Dafaruz/Arduino_prj/pic/solid asm full2.png

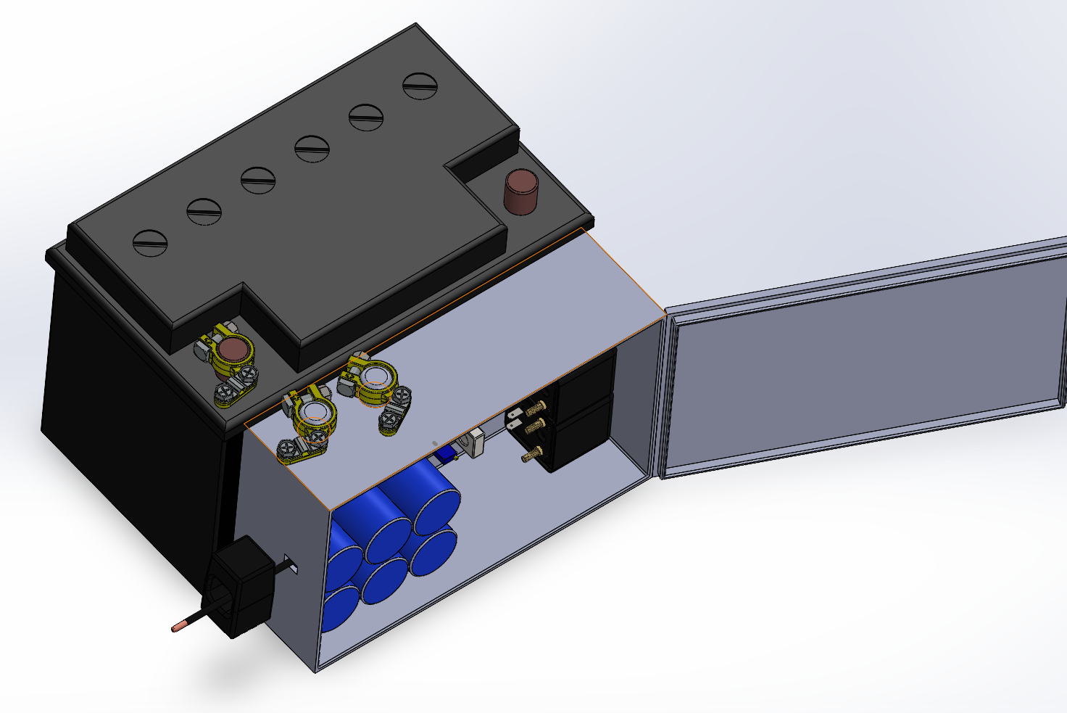
pic/solid asm full2.png
