Dafaruz/Arduino_prj/attachment/Measuring-AC-Current-with-SCT-013-And-Arduino-Connections-scaled.jpg

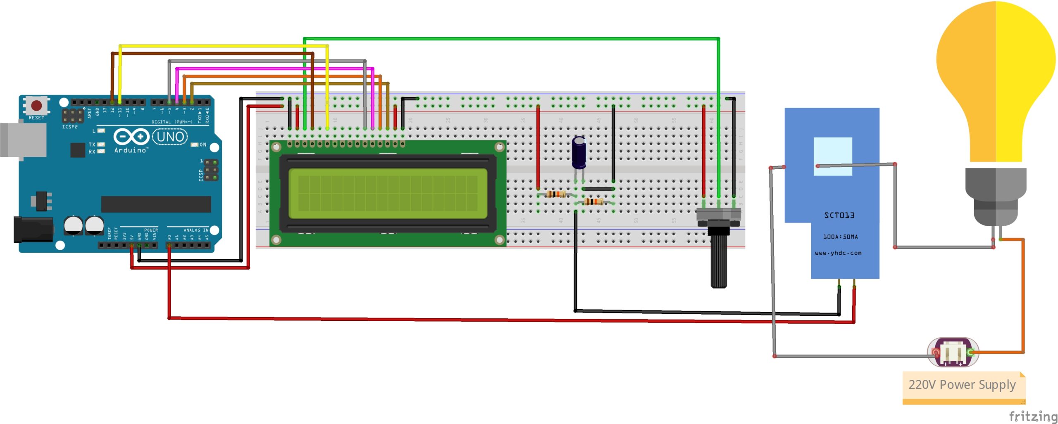
attachment/Measuring-AC-Current-with-SCT-013-And-Arduino-Connections-scaled.jpg
