Dafaruz/Arduino_prj/measurement_data/test on skoda fulty car bat/overview.txt

car with bad battery with droping to 6v on starter pulse 
working voltage 12.75
alternator voltage 13.9v
