Dafaruz/Arduino_prj/word file/poster.pdf

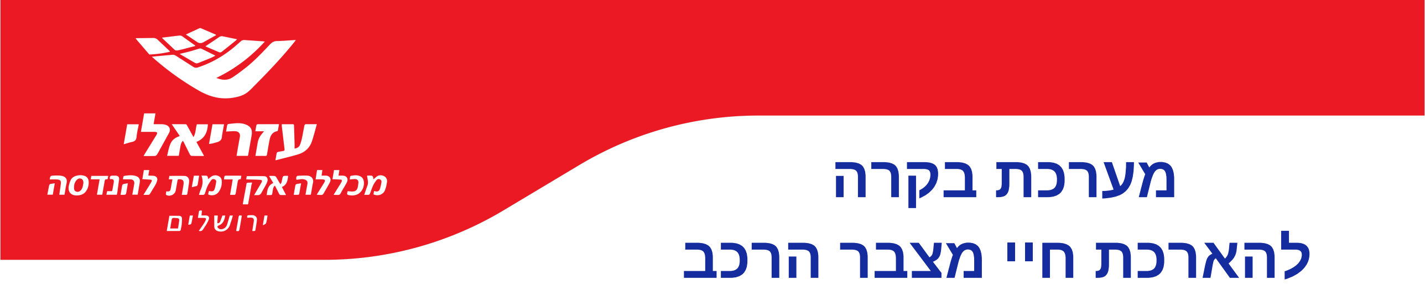
[picture p3: figure]
מערכת בקרה להארכת חיי מצבר הרכב

במהלך הפרויקט ביצענו ניתוחים מעמיקים באמצעות Arduino ונעזרנו בסקופ דיגיטלי לבחינת הדיוק של המדידות, בשל אי הדיוק הפנימי במערכות כמו Arduino. את הנתונים חילצנו לקובצי CSV וביצענו עליהם ניתוח גרפי ב-MATLAB כדי לוודא קוהרנטיות. הממצאים הראו שהמערכת הצליחה למנוע ירידות משמעותיות במתח בעת ההתנעה, ובכך הפחיתה את העומס על המצבר בצורה יעילה.
בפיתוח המערכת, ביצענו כיול ראשוני לחיישני Effect Hall . בנוסף, בוצע

ואופסט למדידות כדי לוודא דיוק מקסימלי כיול נוסף להתחשבות בזרם האפס שנוצר כתוצאה מרעשים סביבתיים, מה שסייע להבטיח יציבות בתוצאות המדידה ובביצועי המערכת.

במהלך התנעת רכב, מתרחשת עלייה פתאומית בדרישות הזרם , מה שגורם ל "הלם חשמלי" במצבר וגורם לשחיקה,

החשמלי
בעיקר ברכבים עם התנעות תכופתיות. בפרויקט זה פותחה מערכת המשלבת קבל-על שמטרתו להפחית את ההלם החשמלי הזה ולמנוע שחיקה מואצת, ובכך להאריך את חיי המצבר. המערכת נועדה להפחית את עומס ההתנעה על מצבר הרכב, לשמור על תפקוד תקין של מערכת ההתנעה, ולהאריך את חיי המצבר.

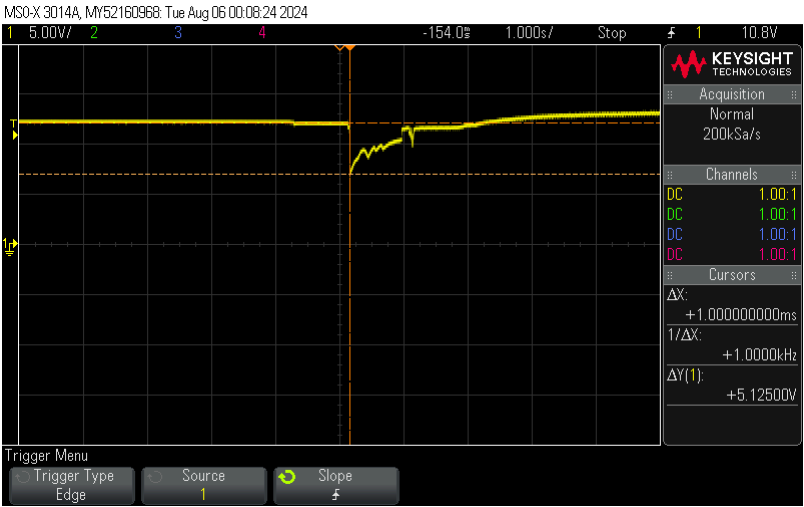
[picture p4: figure]

בפרויקט זה פותחה מערכת שמשלבת קבל-על ומצבר רכב כדי להפחית את השחיקה שנגרמת בהתנעה ולהאריך את חיי , כשהקבל תומך

המצבר. המערכת פועלת באופן אוטומטי במצבר בזמן ההתנעה ומסייע במניעת עומס יתר. המערכת כוללת:
Arduino לניהול הבקרה ושליטה על הממסרים חיישני Effect Hall לניטור זרמים ומתחים בזמן אמת supercapacitor שמספק תמיכה חשמלית במצבי עומס ממסרים לשילוב וניתוק supercapacitor

בנוסף,פותחה ספרייה ייעודית לסינון רעשים בקריאות האנלוגיות, וכן פתרון latch-D המבוסס על Arduino נוסף שהתגבר על שיבושים שנגרמו בשימוש מקביל של .DigitalWrite-ו AnalogRead

מבצעי;ם: דניאל פרוז, נתן סבג מנחים: ד"ר אמיר שמר, מאיר רזווג

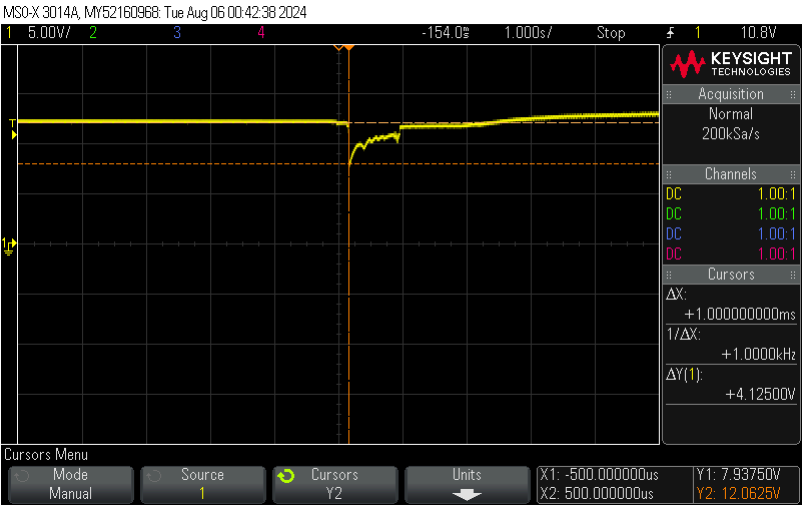
[picture p5: figure]

## יישום ופתרון

### מחקר ופיתוח

### מבוא

בפרויקט זה הצלחנו להקטין את השחיקה במצבר באמצעות ריכוך ההלם החשמלי בזמן התנעה, מה שמאריך את חיי ישנן מספר נקודות

. עם זאת,

המצבר ותורם גם לשיפור סביבתי לשיפור:
החלפת ה-Arduino הנוסף בדלגלגים על מנת לחסוך בעלויות.
פיתוח מעגל משובץ משולב שיחליף את הצורך ב-Arduino לחלוטין.
יצירת אלגוריתם משופר לניטור מצב המצבר ובחירת יחס התנעה משתנה בהתאם למצב המצבר. אינטגרציה של המערכת כולה לתוך המצבר ליצירת מערכת קומפקטית.
יצירת כלוב פראדיי סביב הממסרים להפחתת רעשי הסביבה.

## סיכום ונקודות לשיפור

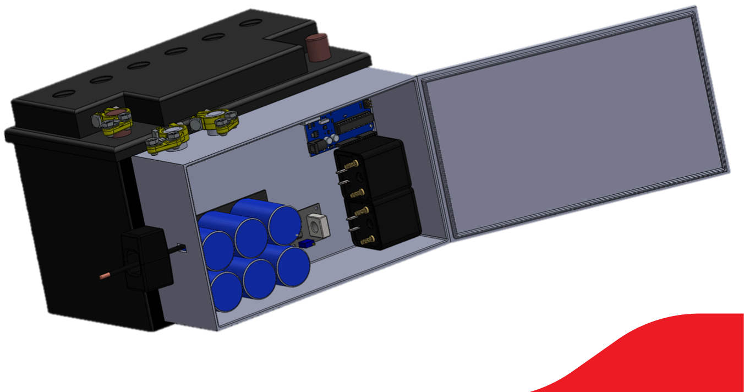
[picture p6: figure]
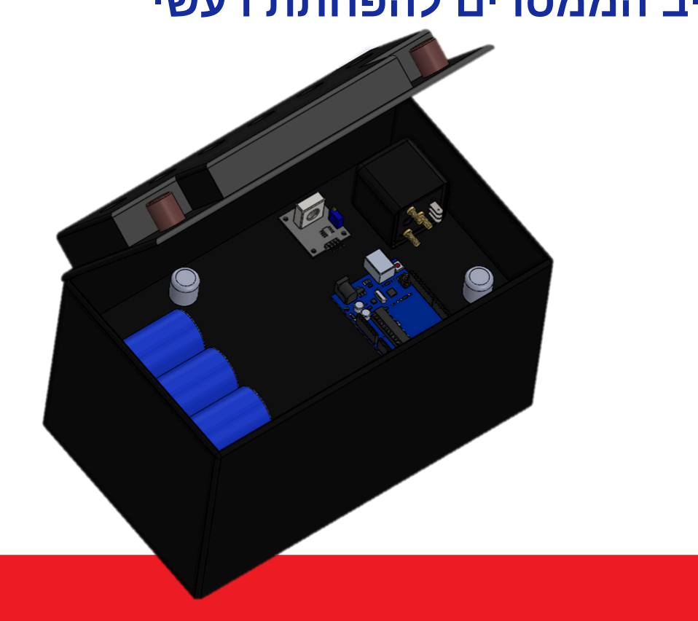
[picture p7: figure]
