Dafaruz/Arduino_prj/attachment/electric_diagram_schem.png

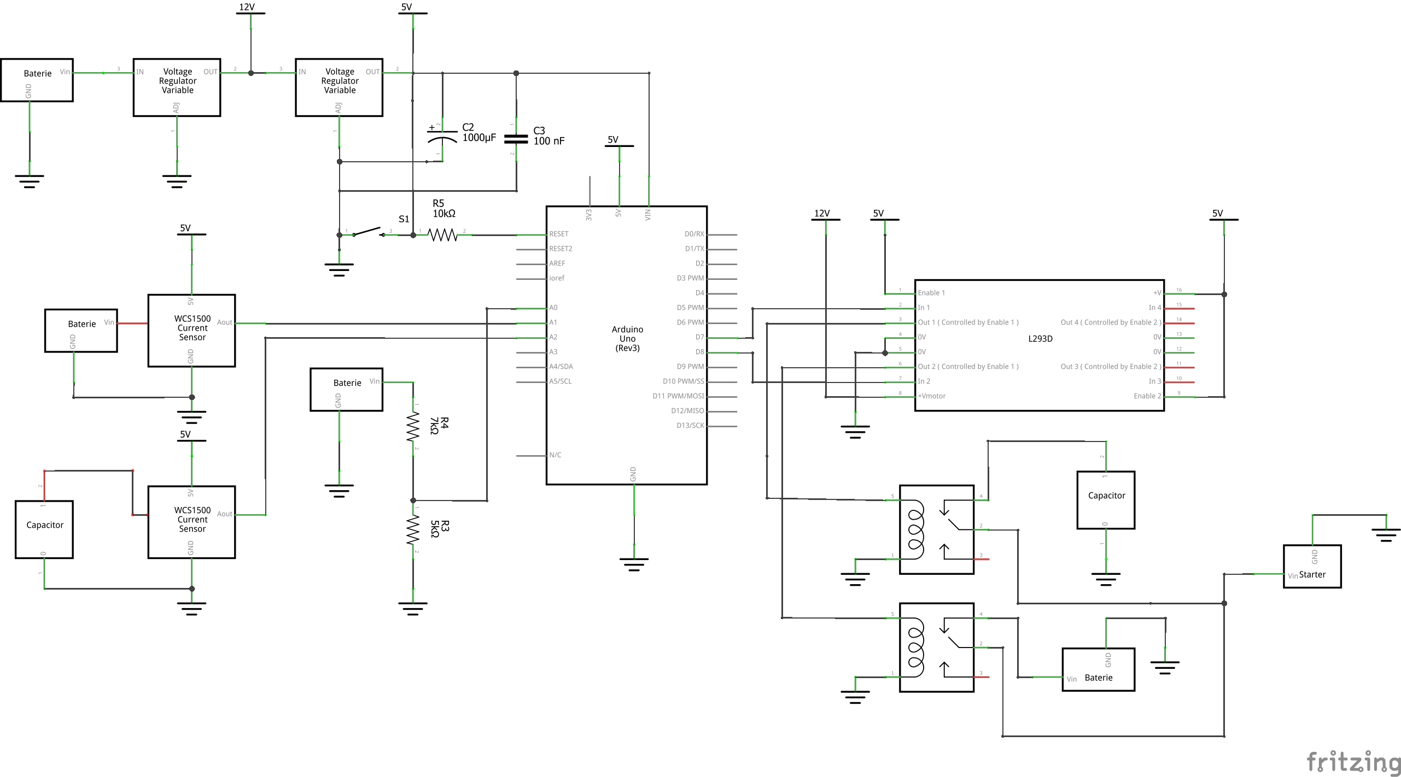
attachment/electric_diagram_schem.png
