Dafaruz/Arduino_prj/attachment/hall efect current formola.png

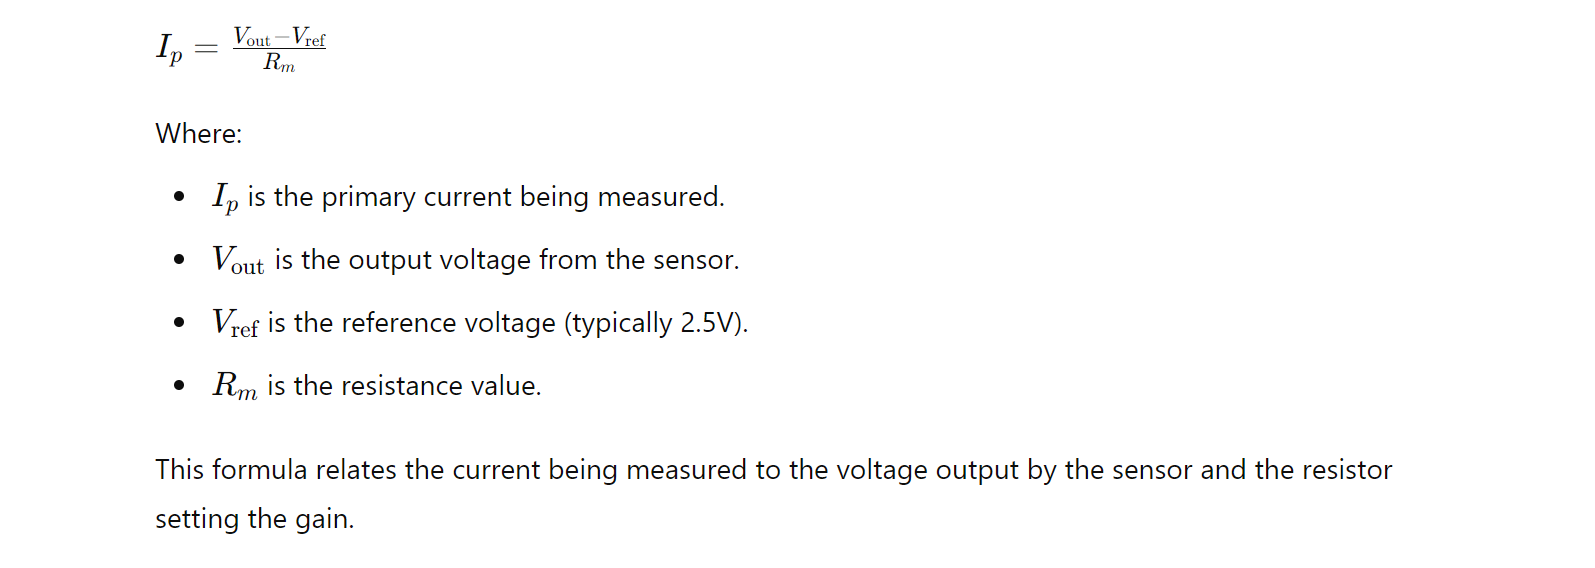
attachment/hall efect current formola.png
