Dafaruz/Arduino_prj/attachment/QNHCK2 hall seensor 200A.webp

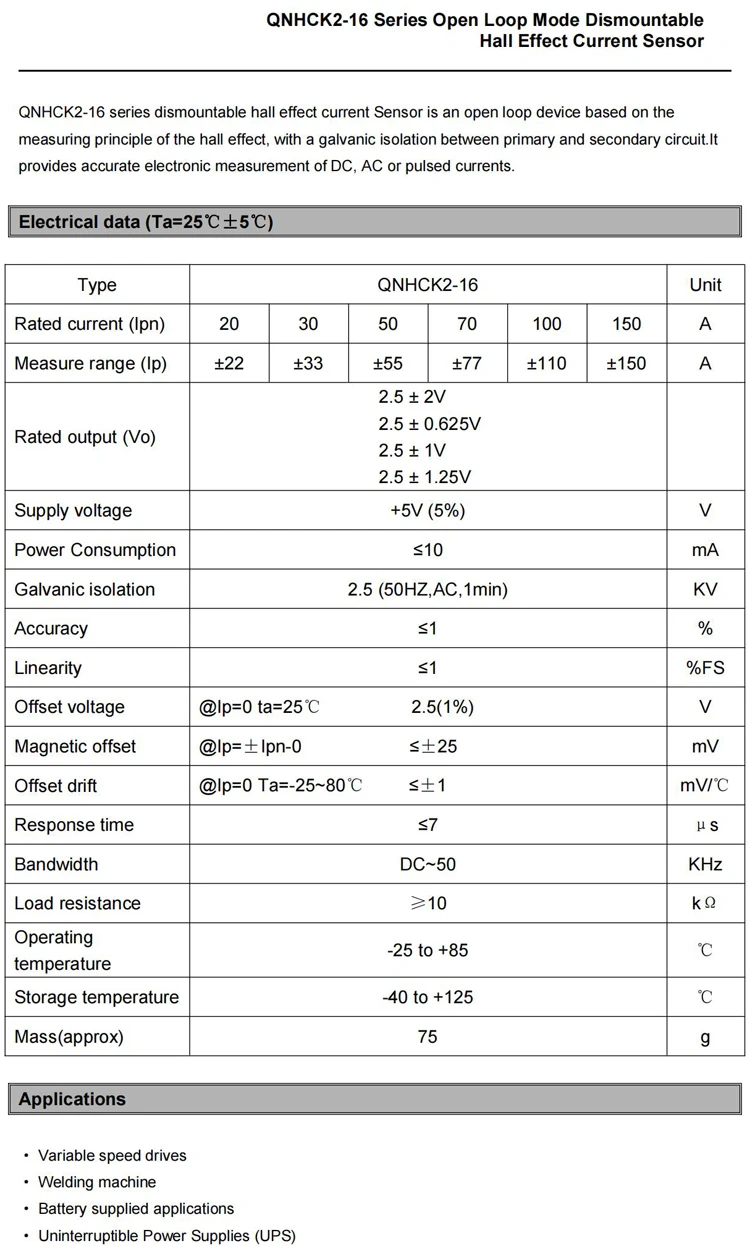
attachment/QNHCK2 hall seensor 200A.webp
