Dafaruz/Arduino_prj/attachment/QNHCK2 hall sensor 200A pic2.webp

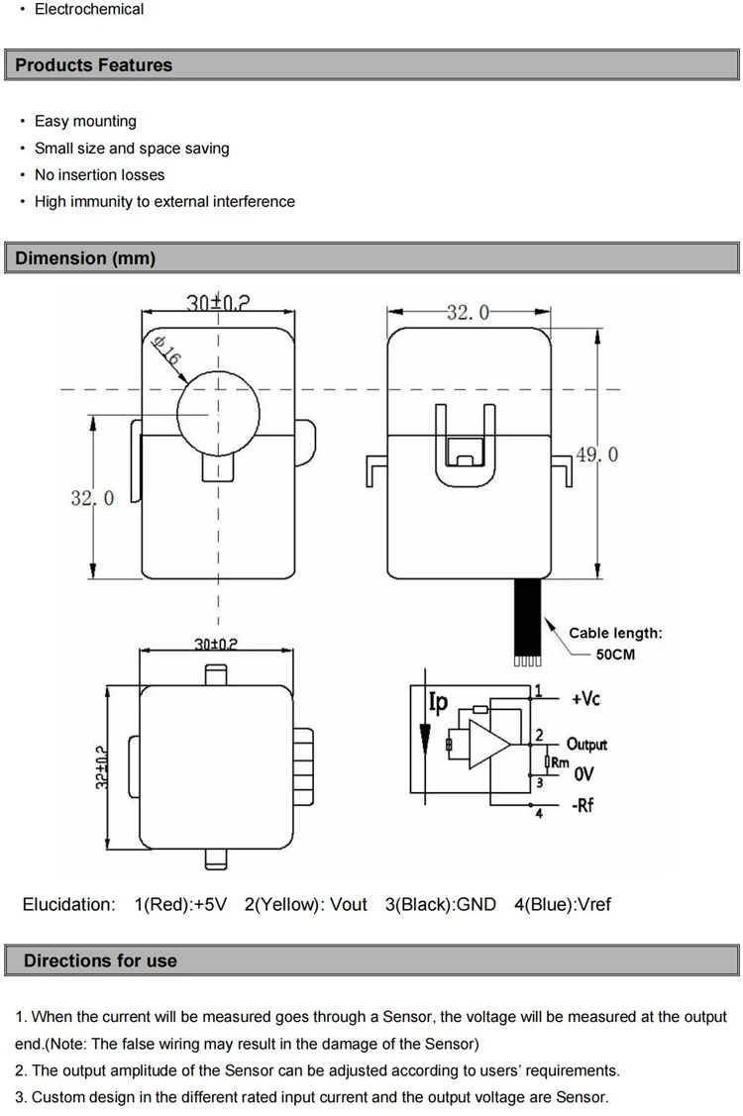
attachment/QNHCK2 hall sensor 200A pic2.webp
