Dafaruz/Arduino_prj/pic/final3.PNG

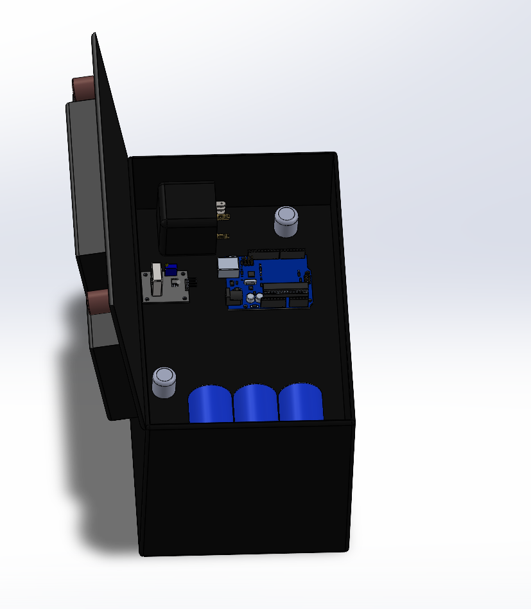
pic/final3.PNG
