Dafaruz/Arduino_prj/pic/final 2.PNG

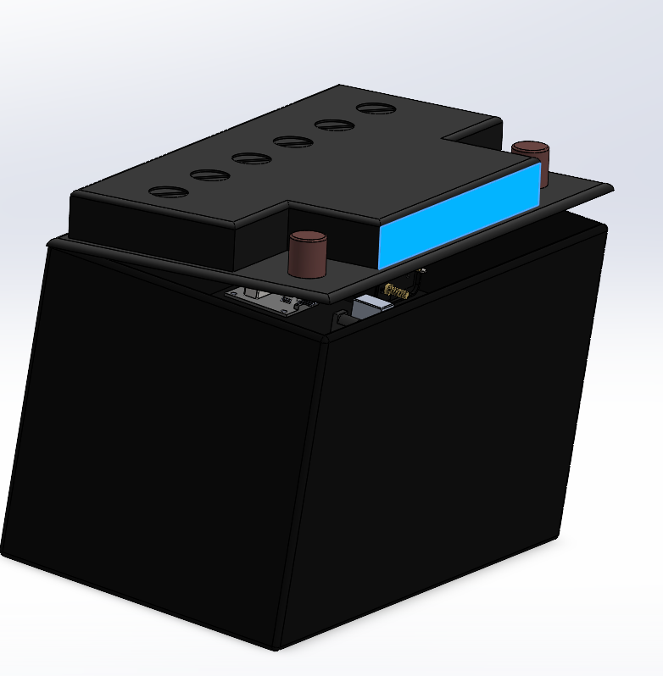
pic/final 2.PNG
