Dafaruz/Arduino_prj/pic/solid asm  full.png

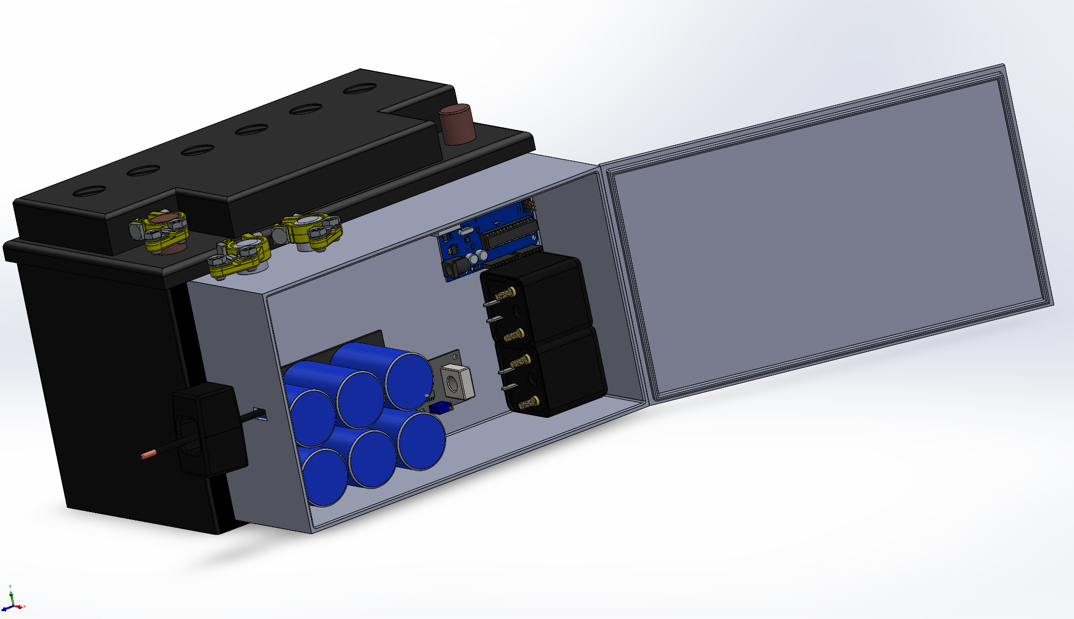
pic/solid asm full.png
