Dafaruz/Arduino_prj/pic/solid asm full3.png

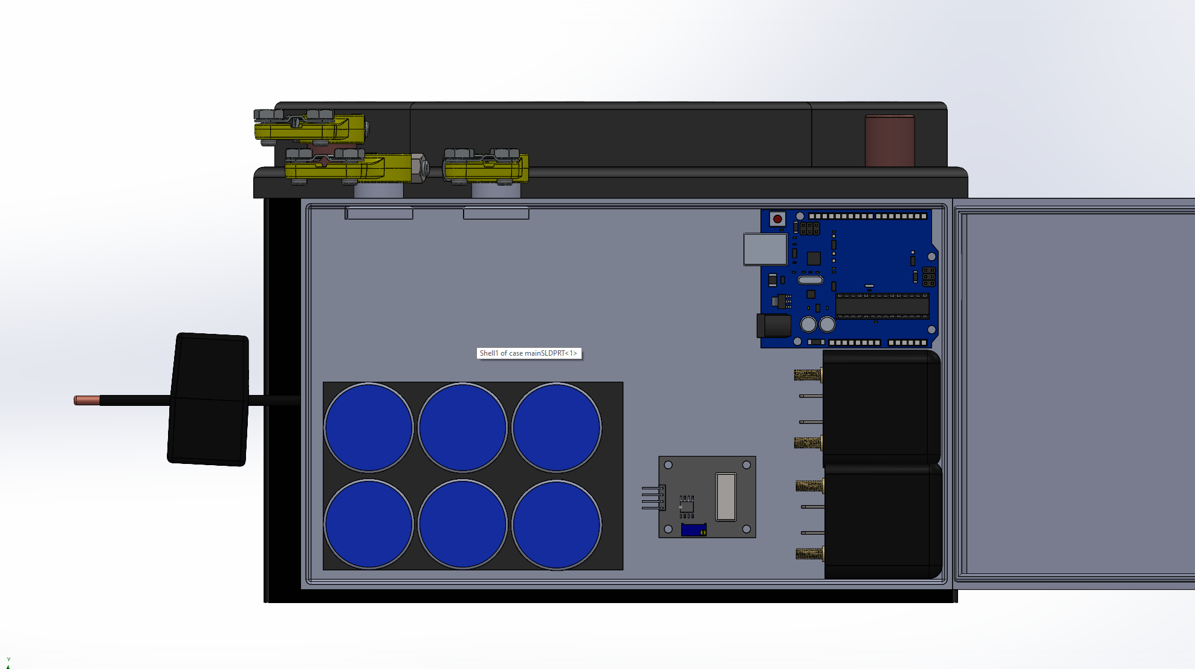
pic/solid asm full3.png
