Dafaruz/Arduino_prj/pic/solid inside the  bat.png

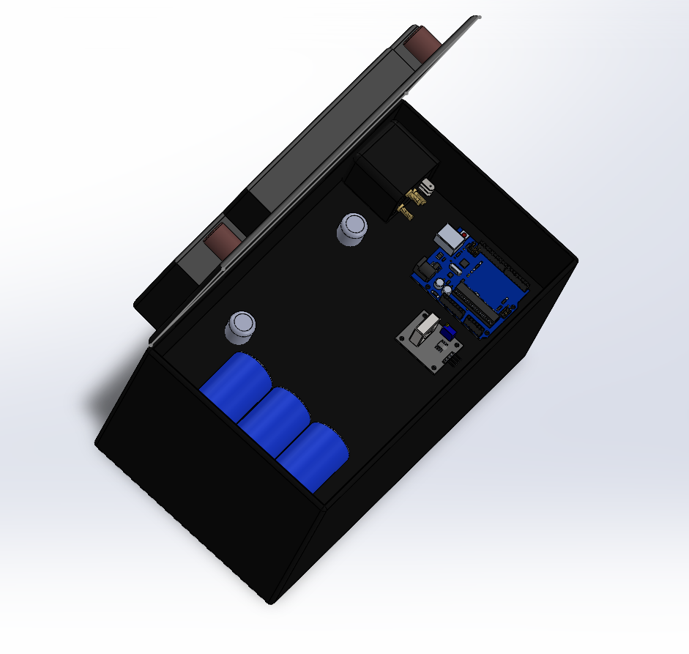
pic/solid inside the bat.png
