Dafaruz/Arduino_prj/pic/‏final inside .PNG

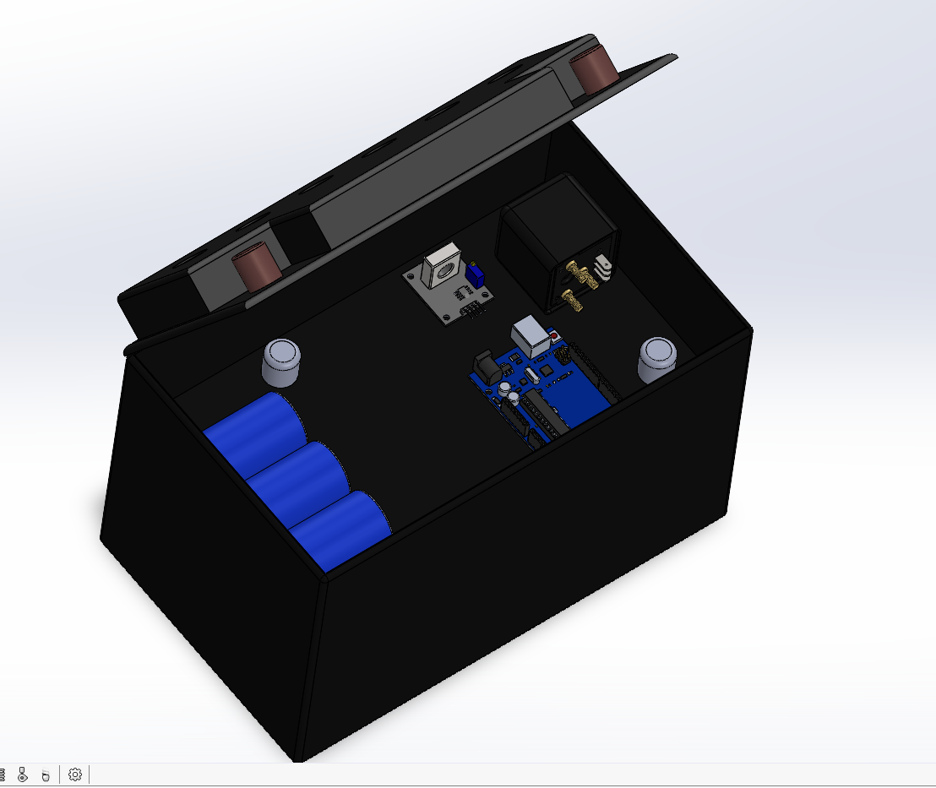
pic/‏final inside .PNG
