Dafaruz/Arduino_prj/measurement_data/test on skoda fulty car bat/with capacitor 3rd (vb-12.7 vcap- 13.3)/test before starter/New Microsoft Word Document.docx

Volt capacitor:13.5V

Volt baterie:12.7V
