Dafaruz/Arduino_prj/measurement_data/test on skoda fulty car bat/no cap 1st exp 1s/no_cap7.csv

x-axis | WaveGen-ARB
second | Volt
0.000000E+000 | +250.0E-03
3.846154E-001 | -250.0E-03
