Dafaruz/Arduino_prj/measurement_data/test on skoda fulty car bat/no cap 1st exp 1s/no_cap5.csv

x-axis | 1
second | Volt
-5.154000E+00 | +12.196307E+00
-5.149000E+00 | +12.351905E+00
-5.144000E+00 | +12.390859E+00
-5.139000E+00 | +12.254618E+00
-5.134000E+00 | +12.196307E+00
-5.129000E+00 | +12.196307E+00
-5.124000E+00 | +12.196307E+00
-5.119000E+00 | +12.261050E+00
-5.114000E+00 | +12.196307E+00
-5.109000E+00 | +12.196307E+00
-5.104000E+00 | +12.377995E+00
-5.099000E+00 | +12.196307E+00
-5.094000E+00 | +12.196307E+00
-5.089000E+00 | +12.397312E+00
-5.084000E+00 | +12.196307E+00
-5.079000E+00 | +12.319704E+00
-5.074000E+00 | +12.196307E+00
-5.069000E+00 | +12.377633E+00
-5.064000E+00 | +12.196307E+00
-5.059000E+00 | +12.196307E+00
-5.054000E+00 | +12.196307E+00
-5.049000E+00 | +12.196307E+00
-5.044000E+00 | +12.196307E+00
-5.039000E+00 | +12.196307E+00
-5.034000E+00 | +12.196307E+00
-5.029000E+00 | +12.196307E+00
-5.024000E+00 | +12.196307E+00
-5.019000E+00 | +12.300407E+00
-5.014000E+00 | +12.196307E+00
-5.009000E+00 | +12.196307E+00
-5.004000E+00 | +12.196307E+00
-4.999000E+00 | +12.196307E+00
-4.994000E+00 | +12.196307E+00
-4.989000E+00 | +12.196307E+00
-4.984000E+00 | +12.196307E+00
-4.979000E+00 | +12.196307E+00
-4.974000E+00 | +12.196307E+00
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
