Dafaruz/Arduino_prj/measurement_data/test on skoda fulty car bat/no cap 1st exp 200ms/no_cap1.csv

x-axis | 1
second | Volt
-1.15400E+00
-1.15300E+00 | +12.19631E+00
-1.15200E+00 | +12.19631E+00
-1.15100E+00 | +12.19631E+00
-1.15000E+00 | +12.19631E+00
-1.14900E+00 | +12.19631E+00
-1.14800E+00 | +12.19631E+00
-1.14700E+00 | +12.07967E+00
-1.14600E+00 | +12.19631E+00
-1.14500E+00 | +12.19631E+00
-1.14400E+00 | +11.99530E+00
-1.14300E+00 | +12.19631E+00
-1.14200E+00 | +12.19631E+00
-1.14100E+00 | +12.17053E+00
-1.14000E+00 | +12.19631E+00
-1.13900E+00 | +12.06681E+00
-1.13800E+00 | +12.19631E+00
-1.13700E+00 | +12.19631E+00
-1.13600E+00 | +12.19631E+00
-1.13500E+00 | +12.19631E+00
-1.13400E+00 | +12.19631E+00
-1.13300E+00 | +12.15766E+00
-1.13200E+00 | +12.19631E+00
-1.13100E+00 | +12.19631E+00
-1.13000E+00 | +12.18952E+00
-1.12900E+00 | +12.19631E+00
-1.12800E+00 | +12.19631E+00
-1.12700E+00 | +12.19631E+00
-1.12600E+00 | +12.19631E+00
-1.12500E+00 | +12.19631E+00
-1.12400E+00 | +12.19631E+00
-1.12300E+00 | +12.04108E+00
-1.12200E+00 | +12.19631E+00
-1.12100E+00 | +12.19631E+00
-1.12000E+00 | +12.08651E+00
-1.11900E+00 | +12.03465E+00
-1.11800E+00 | +12.19631E+00
-1.11700E+00 | +12.19631E+00
-1.11600E+00 | +12.19631E+00
-1.11500E+00 | +12.19631E+00
-1.11400E+00 | +12.17736E+00
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
