Dafaruz/Arduino_prj/measurement_data/test on skoda fulty car bat/with capacitor vbat 12.7 vcap 12.6/no_cap23_1.csv

x-axis | 1
second | Volt
-5.15625006639 | 12.1963
-5.15125006639 | 12.1963
-5.14625006639 | 12.1963
-5.14125006639 | 12.3973
-5.13625006639 | 12.1963
-5.13125006639 | 12.1963
-5.12625006639 | 12.3973
-5.12125006639 | 12.1963
-5.11625006639 | 12.1963
-5.11125006639 | 12.3973
-5.10625006639 | 12.1963
-5.10125006639 | 12.3973
-5.09625006639 | 12.3973
-5.09125006639 | 12.1963
-5.08625006639 | 12.1963
-5.08125006639 | 12.3973
-5.07625006639 | 12.1963
-5.07125006639 | 12.1963
-5.06625006639 | 12.1963
-5.06125006639 | 12.3973
-5.05625006639 | 12.1963
-5.05125006639 | 12.1963
-5.04625006639 | 12.3973
-5.04125006639 | 12.1963
-5.03625006639 | 12.1963
-5.03125006639 | 12.3973
-5.02625006639 | 12.3973
-5.02125006639 | 12.3973
-5.01625006639 | 12.1963
-5.01125006639 | 12.3973
-5.00625006639 | 12.3973
-5.00125006639 | 12.1963
-4.99625006639 | 12.1963
-4.99125006639 | 12.3973
-4.98625006639 | 12.1963
-4.98125006639 | 12.1963
-4.97625006639 | 12.1963
-4.97125006639 | 12.3973
-4.96625006639 | 12.3973
-4.96125006639 | 12.1963
-4.95625006639 | 12.3973
-4.95125006639 | 12.1963
-4.94625006639 | 12.1963
-4.94125006639 | 12.1963
-4.93625006639 | 12.1963
-4.93125006639 | 12.3973
-4.92625006639 | 12.1963
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
