Dafaruz/Arduino_prj/measurement_data/test on skoda fulty car bat/with capacitor vbat-12.7 vcao 13.9)/no_cap20_1.csv

x-axis | 1
second | Volt
-5.15625006639 | 13.6033
-5.15125006639 | 13.8043
-5.14625006639 | 13.8043
-5.14125006639 | 13.6033
-5.13625006639 | 13.8043
-5.13125006639 | 13.8043
-5.12625006639 | 13.6033
-5.12125006639 | 13.8043
-5.11625006639 | 13.8043
-5.11125006639 | 13.8043
-5.10625006639 | 13.8043
-5.10125006639 | 13.6033
-5.09625006639 | 13.8043
-5.09125006639 | 13.8043
-5.08625006639 | 13.8043
-5.08125006639 | 13.8043
-5.07625006639 | 13.6033
-5.07125006639 | 13.6033
-5.06625006639 | 13.8043
-5.06125006639 | 13.6033
-5.05625006639 | 13.8043
-5.05125006639 | 13.6033
-5.04625006639 | 13.6033
-5.04125006639 | 13.6033
-5.03625006639 | 13.8043
-5.03125006639 | 13.8043
-5.02625006639 | 13.6033
-5.02125006639 | 13.8043
-5.01625006639 | 13.8043
-5.01125006639 | 13.6033
-5.00625006639 | 13.8043
-5.00125006639 | 13.8043
-4.99625006639 | 13.6033
-4.99125006639 | 13.6033
-4.98625006639 | 13.6033
-4.98125006639 | 13.6033
-4.97625006639 | 13.8043
-4.97125006639 | 13.6033
-4.96625006639 | 13.8043
-4.96125006639 | 13.6033
-4.95625006639 | 13.6033
-4.95125006639 | 13.6033
-4.94625006639 | 13.8043
-4.94125006639 | 13.8043
-4.93625006639 | 13.8043
-4.93125006639 | 13.8043
-4.92625006639 | 13.8043
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
