Dafaruz/Arduino_prj/measurement_data/test on skoda fulty car bat/with capacitor vbat-12.7 vcap 13.7)/no_cap17_1.csv

x-axis | 1
second | Volt
-5.156250066 | 12.3973
-5.151250066 | 12.3973
-5.146250066 | 12.3973
-5.141250066 | 12.3973
-5.136250066 | 12.3973
-5.131250066 | 12.3973
-5.126250066 | 12.3973
-5.121250066 | 12.3973
-5.116250066 | 12.3973
-5.111250066 | 12.1963
-5.106250066 | 12.3973
-5.101250066 | 12.3973
-5.096250066 | 12.3973
-5.091250066 | 12.3973
-5.086250066 | 12.3973
-5.081250066 | 12.3973
-5.076250066 | 12.3973
-5.071250066 | 12.3973
-5.066250066 | 12.3973
-5.061250066 | 12.3973
-5.056250066 | 12.3973
-5.051250066 | 12.3973
-5.046250066 | 12.3973
-5.041250066 | 12.3973
-5.036250066 | 12.3973
-5.031250066 | 12.3973
-5.026250066 | 12.3973
-5.021250066 | 12.3973
-5.016250066 | 12.3973
-5.011250066 | 12.3973
-5.006250066 | 12.3973
-5.001250066 | 12.3973
-4.996250066 | 12.3973
-4.991250066 | 12.3973
-4.986250066 | 12.3973
-4.981250066 | 12.3973
-4.976250066 | 12.3973
-4.971250066 | 12.3973
-4.966250066 | 12.3973
-4.961250066 | 12.3973
-4.956250066 | 12.3973
-4.951250066 | 12.3973
-4.946250066 | 12.3973
-4.941250066 | 12.3973
-4.936250066 | 12.3973
-4.931250066 | 12.1963
-4.926250066 | 12.3973
-4.921250066 | 12.3973
-4.916250066 | 12.3973
-4.911250066 | 12.3973
-4.906250066 | 12.3973
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
