Dafaruz/Arduino_prj/measurement_data/current meshurment hall efect_no_cap (1).jpg

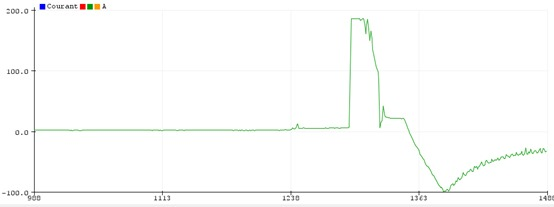
measurement_data/current meshurment hall efect_no_cap (1).jpg
