Dafaruz/Arduino_prj/measurement_data/current meshurment hall efect_with_cap.jpg

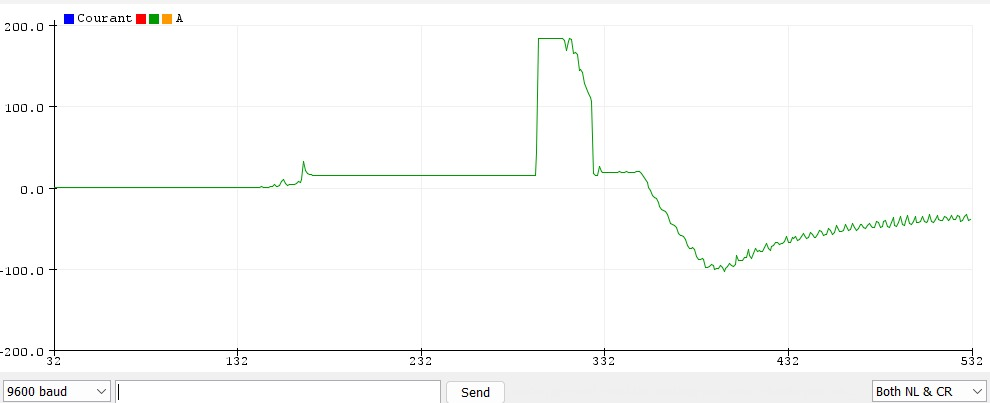
measurement_data/current meshurment hall efect_with_cap.jpg
