Dafaruz/Arduino_prj/measurement_data/test on skoda fulty car bat/no cap 1st exp 200ms/no_cap0.png

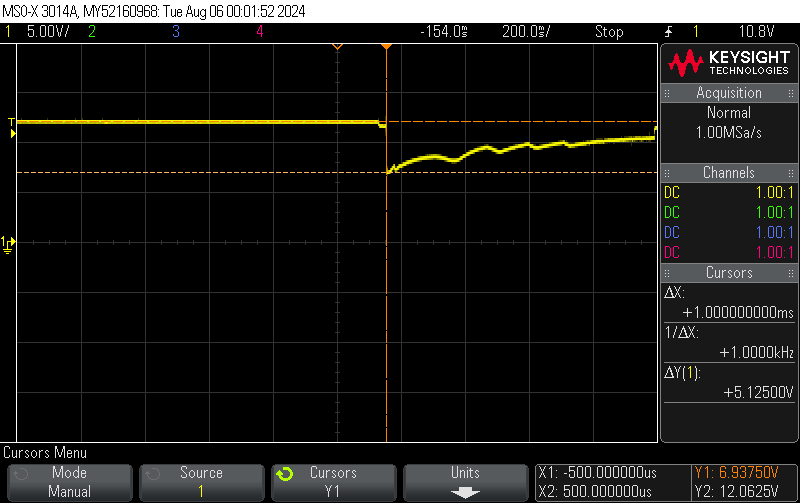
measurement_data/test on skoda fulty car bat/no cap 1st exp 200ms/no_cap0.png
