Dafaruz/Arduino_prj/measurement_data/tests with bososter c4 disel good bat/c4 no booster.jpg

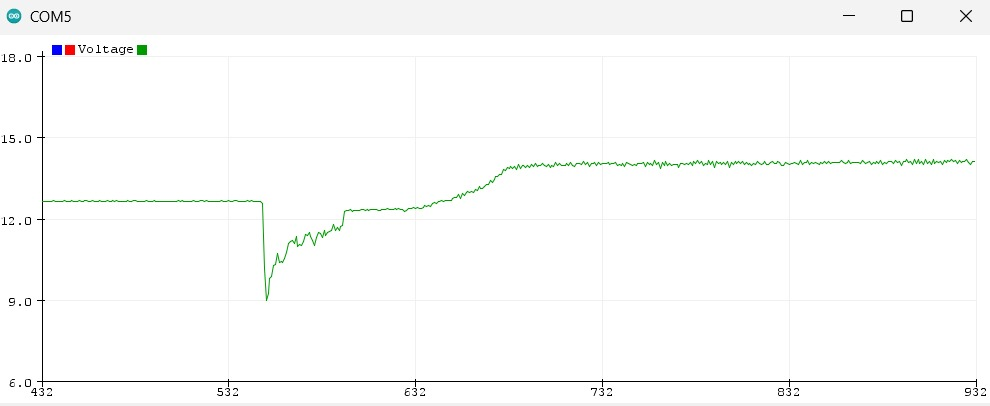
measurement_data/tests with bososter c4 disel good bat/c4 no booster.jpg
