Dafaruz/Arduino_prj/(commit log)

2024-10-09 add the last file with NDAS to reduce noise in the sys
    [code_project_6.ino]
2024-10-09 fix bug in the set zero
    [code_project_7.ino]
2024-10-13 all data import
    [no_cap1.csv, no_cap10.csv, no_cap13_1.csv, no_cap14.csv, no_cap17_1.csv, no_cap18.csv, no_cap20_1.csv, no_cap21.csv]
2024-10-15 Add files via upload
    power point end
2024-10-15 re org
    [no_cap1.csv, no_cap10.csv, no_cap13_1.csv, no_cap14.csv, no_cap17_1.csv, no_cap18.csv, no_cap20_1.csv, no_cap21.csv]
2025-01-23 done robo arm
